goutham2018/Illizarov-Distraction-Osteogenesis/pcb_2.jpg

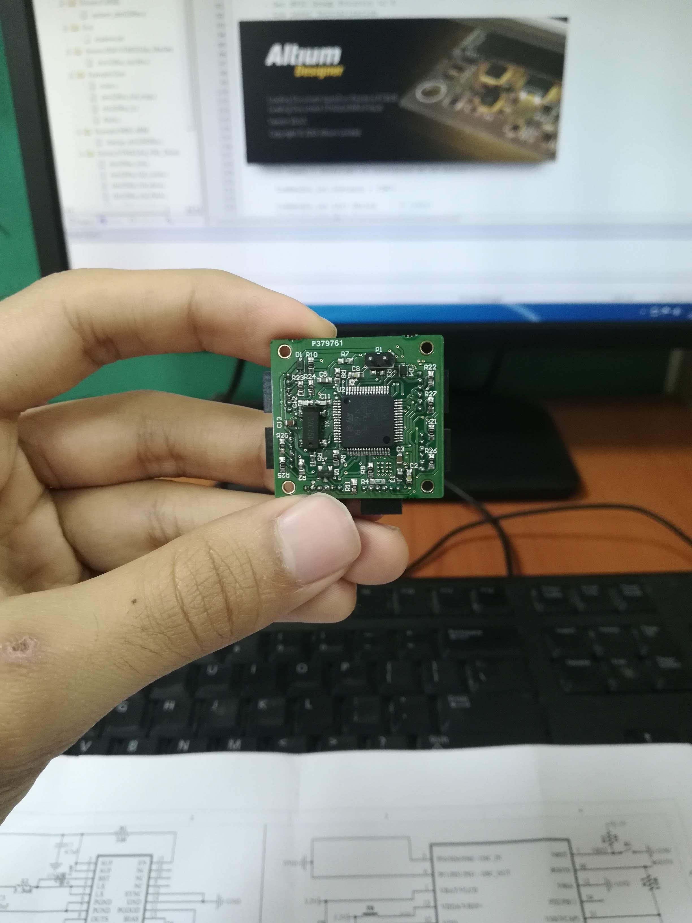
pcb_2.jpg
