goutham2018/Illizarov-Distraction-Osteogenesis/pcb_1.jpg

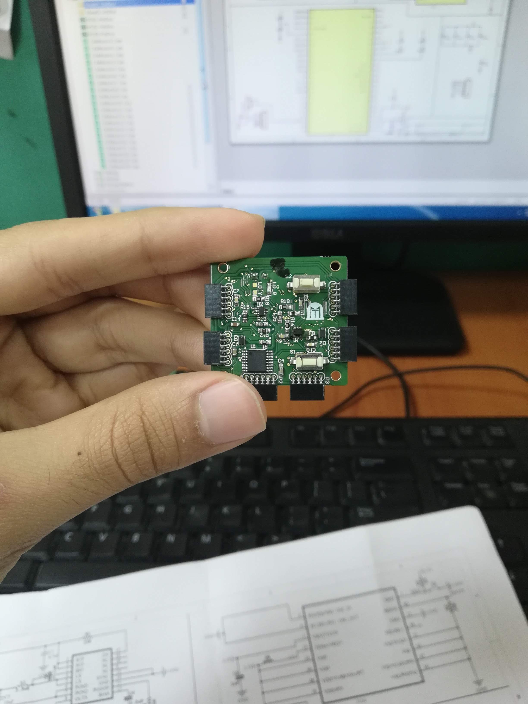
pcb_1.jpg
