goutham2018/Illizarov-Distraction-Osteogenesis/schematic/Illizarov.pdf

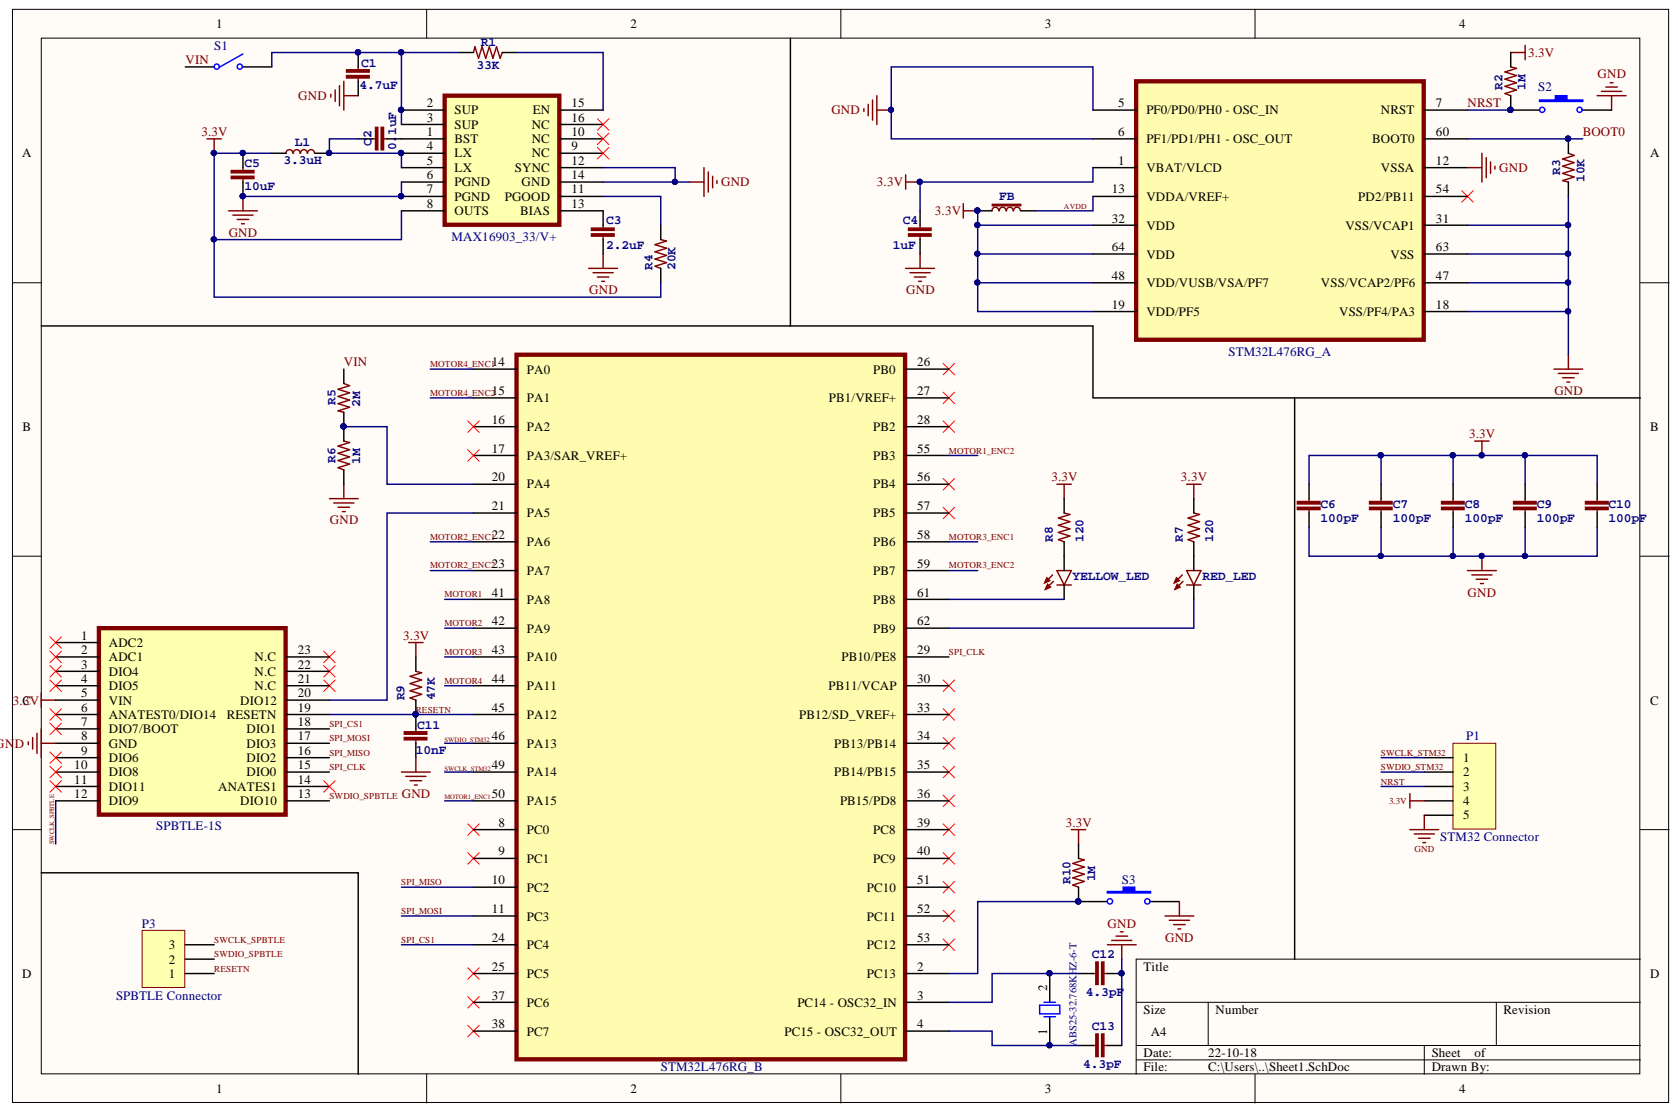
[picture p11: page 1]

SUP 2

VIN 5 | PA12 45
ANATEST0/DIO14 6 | | RESETN

DIO7/BOOT 7 | | C11 SWDIO_STM32 | PA13 46

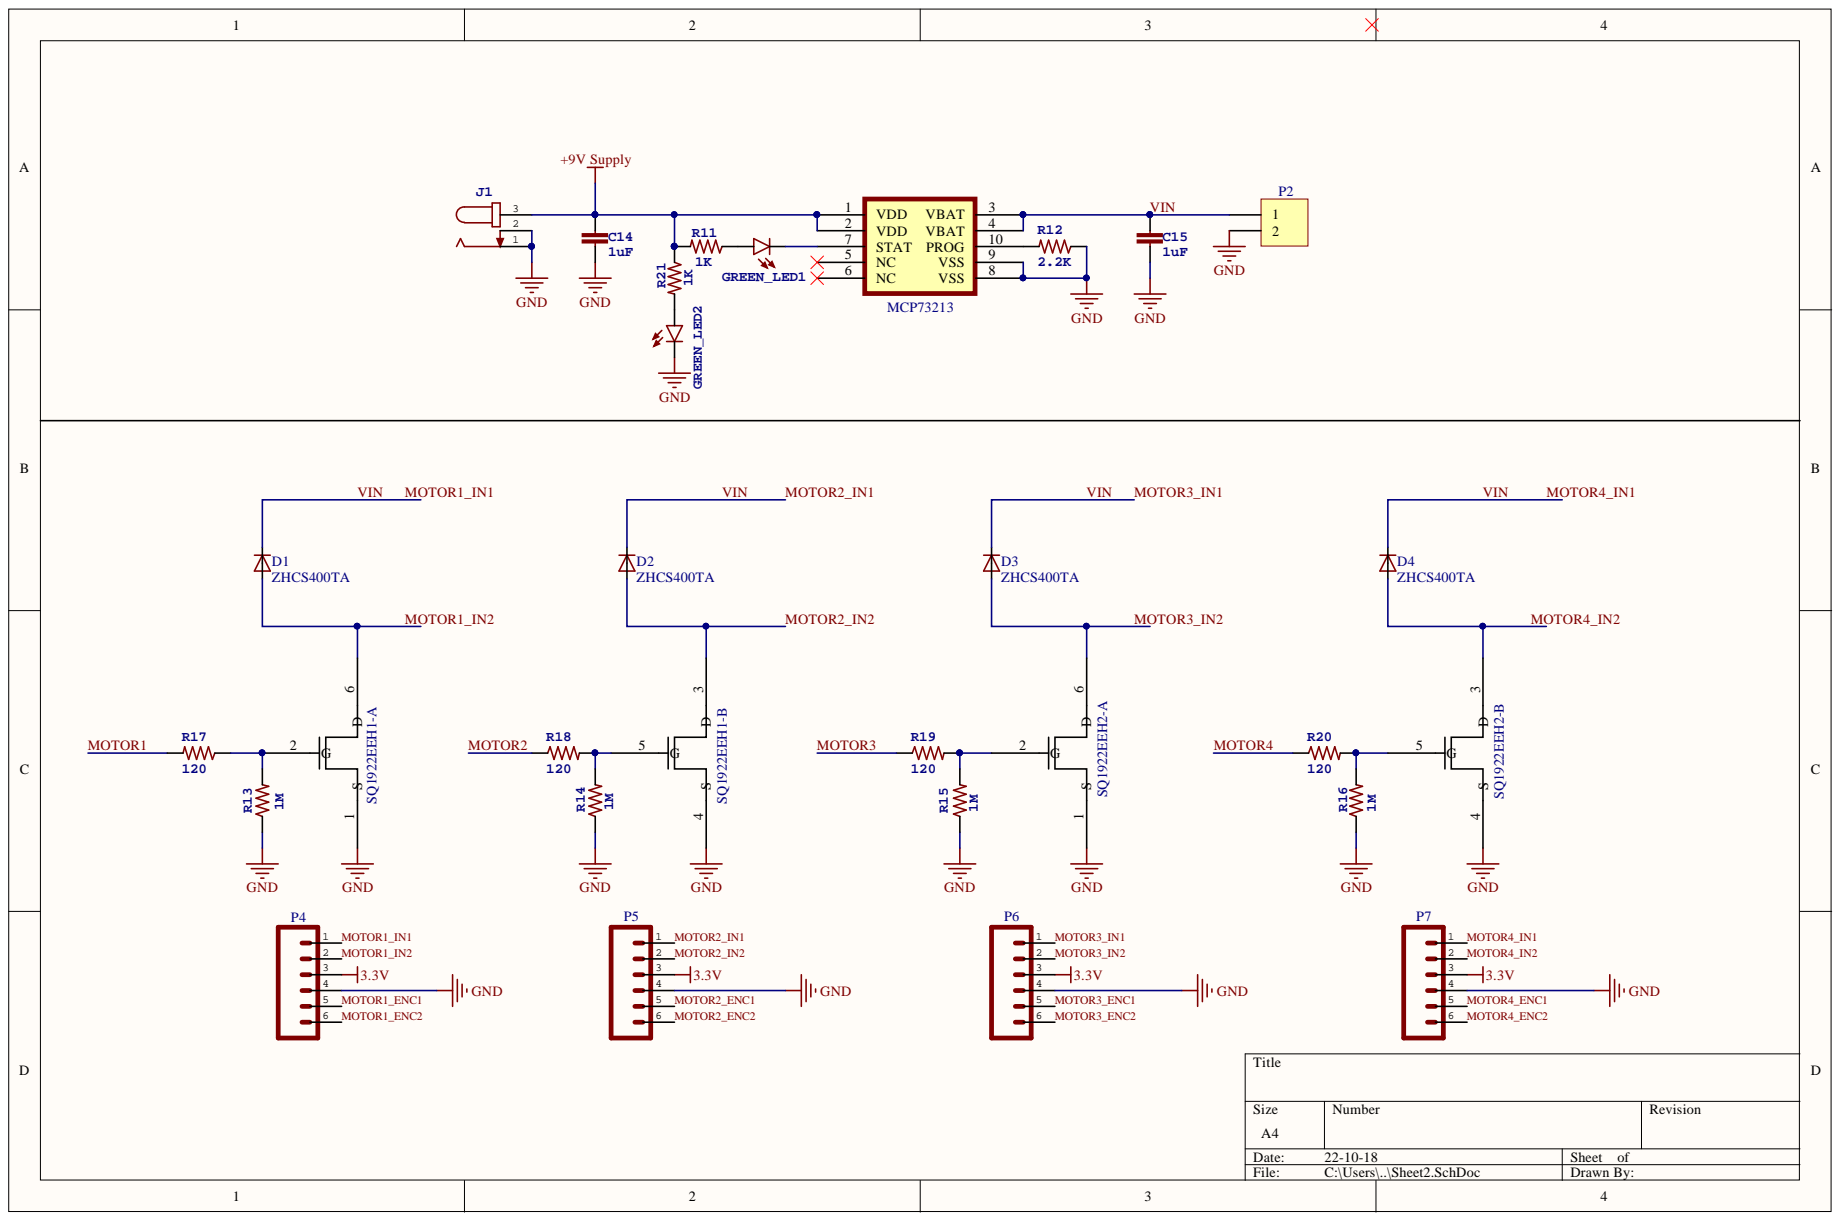
[picture p12: page 2]

2 | VDD 2
1 | STAT 7 NC 5
