goutham2018/Illizarov-Distraction-Osteogenesis/Inc/pin_config.h

#ifndef __PIN_CONFIG__
#define __PIN_CONFIG__

#define MOTOR_1_PORT_1 GPIOC
#define MOTOR_1_PORT_2 GPIOC

#define MOTOR_1_PIN_A GPIO_PIN_7
#define MOTOR_1_PIN_B GPIO_PIN_6

#define MOTOR_2_PORT_1 GPIOC
#define MOTOR_2_PORT_2 GPIOC

#define MOTOR_2_PIN_A GPIO_PIN_9
#define MOTOR_2_PIN_B GPIO_PIN_8

#define MOTOR_3_PORT_1 GPIOA
#define MOTOR_3_PORT_2 GPIOA

#define MOTOR_3_PIN_A GPIO_PIN_9
#define MOTOR_3_PIN_B GPIO_PIN_8

#define MOTOR_4_PORT_1 GPIOA
#define MOTOR_4_PORT_2 GPIOA

#define MOTOR_4_PIN_A GPIO_PIN_11
#define MOTOR_4_PIN_B GPIO_PIN_10

#define ENCODER_1_PIN_A_PORT GPIOA
#define ENCODER_1_PIN_A GPIO_PIN_15
#define ENCODER_1_PIN_B_PORT GPIOB
#define ENCODER_1_PIN_B GPIO_PIN_3

#define ENCODER_2_PIN_A_PORT GPIOA
#define ENCODER_2_PIN_B_PORT GPIOA
#define ENCODER_2_PIN_A GPIO_PIN_6
#define ENCODER_2_PIN_B GPIO_PIN_7

#define ENCODER_3_PIN_A_PORT GPIOB
#define ENCODER_3_PIN_B_PORT GPIOB
#define ENCODER_3_PIN_A GPIO_PIN_6
#define ENCODER_3_PIN_B GPIO_PIN_7

#define ENCODER_4_PIN_A_PORT GPIOA
#define ENCODER_4_PIN_B_PORT GPIOA
#define ENCODER_4_PIN_A GPIO_PIN_0
#define ENCODER_4_PIN_B GPIO_PIN_1


#endif
