goutham2018/Illizarov-Distraction-Osteogenesis/Inc/flash.h

/* Define to prevent recursive inclusion -------------------------------------*/
#ifndef __FLASH_H
#define __FLASH_H

/* Includes ------------------------------------------------------------------*/
#include "stm32l4xx_hal.h"
#include "stm32l4xx_nucleo.h"


/* Exported types ------------------------------------------------------------*/
/* Exported constants --------------------------------------------------------*/

#define DATA_BASE_START_ADDR   				ADDR_FLASH_PAGE_256   /* Start @ of data base area */
#define DATA_BASE_START_PAGE_NO				256

#define PATIENT_DETAILS_ADDR   				ADDR_FLASH_PAGE_261
#define PATIENT_DETAILS_PAGE_NO				261

#define DEVICE_CONFIG_ADDR     				ADDR_FLASH_PAGE_266
#define DEVICE_CONFIG_PAGE_NO					266

#define DEVICE_DATA_BACKUP_ADDR 			ADDR_FLASH_PAGE_271
#define DEVICE_DATA_BACKUP_PAGE_NO		271

#define MOTOR_1_DATA_BACKUP_ADDR 			ADDR_FLASH_PAGE_272
#define MOTOR_1_DATA_BACKUP_PAGE_NO		272

#define MOTOR_2_DATA_BACKUP_ADDR 			ADDR_FLASH_PAGE_273
#define MOTOR_2_DATA_BACKUP_PAGE_NO		273

#define MOTOR_3_DATA_BACKUP_ADDR 			ADDR_FLASH_PAGE_274
#define MOTOR_3_DATA_BACKUP_PAGE_NO 	274

#define MOTOR_4_DATA_BACKUP_ADDR 			ADDR_FLASH_PAGE_275
#define MOTOR_4_DATA_BACKUP_PAGE_NO		275

#define PATIENT_LOG_ADDR							ADDR_FLASH_PAGE_300
#define PATIENT_LOG_PAGE_NO						300
#define PATIENT_LOG_PAGES					200

#define flash_read_ok 0
/* Exported macro ------------------------------------------------------------*/
/* Base address of the Flash sectors */

#define ADDR_FLASH_PAGE_0     ((uint32_t)0x08000000) /* Base @ of Page 0, 2 Kbytes */
#define ADDR_FLASH_PAGE_1     ((uint32_t)0x08000800) /* Base @ of Page 1, 2 Kbytes */
#define ADDR_FLASH_PAGE_2     ((uint32_t)0x08001000) /* Base @ of Page 2, 2 Kbytes */
#define ADDR_FLASH_PAGE_3     ((uint32_t)0x08001800) /* Base @ of Page 3, 2 Kbytes */
#define ADDR_FLASH_PAGE_4     ((uint32_t)0x08002000) /* Base @ of Page 4, 2 Kbytes */
#define ADDR_FLASH_PAGE_5     ((uint32_t)0x08002800) /* Base @ of Page 5, 2 Kbytes */
#define ADDR_FLASH_PAGE_6     ((uint32_t)0x08003000) /* Base @ of Page 6, 2 Kbytes */
#define ADDR_FLASH_PAGE_7     ((uint32_t)0x08003800) /* Base @ of Page 7, 2 Kbytes */
#define ADDR_FLASH_PAGE_8     ((uint32_t)0x08004000) /* Base @ of Page 8, 2 Kbytes */
#define ADDR_FLASH_PAGE_9     ((uint32_t)0x08004800) /* Base @ of Page 9, 2 Kbytes */
#define ADDR_FLASH_PAGE_10    ((uint32_t)0x08005000) /* Base @ of Page 10, 2 Kbytes */
#define ADDR_FLASH_PAGE_11    ((uint32_t)0x08005800) /* Base @ of Page 11, 2 Kbytes */
#define ADDR_FLASH_PAGE_12    ((uint32_t)0x08006000) /* Base @ of Page 12, 2 Kbytes */
#define ADDR_FLASH_PAGE_13    ((uint32_t)0x08006800) /* Base @ of Page 13, 2 Kbytes */
#define ADDR_FLASH_PAGE_14    ((uint32_t)0x08007000) /* Base @ of Page 14, 2 Kbytes */
#define ADDR_FLASH_PAGE_15    ((uint32_t)0x08007800) /* Base @ of Page 15, 2 Kbytes */
#define ADDR_FLASH_PAGE_16    ((uint32_t)0x08008000) /* Base @ of Page 16, 2 Kbytes */
#define ADDR_FLASH_PAGE_17    ((uint32_t)0x08008800) /* Base @ of Page 17, 2 Kbytes */
#define ADDR_FLASH_PAGE_18    ((uint32_t)0x08009000) /* Base @ of Page 18, 2 Kbytes */
#define ADDR_FLASH_PAGE_19    ((uint32_t)0x08009800) /* Base @ of Page 19, 2 Kbytes */
#define ADDR_FLASH_PAGE_20    ((uint32_t)0x0800A000) /* Base @ of Page 20, 2 Kbytes */
#define ADDR_FLASH_PAGE_21    ((uint32_t)0x0800A800) /* Base @ of Page 21, 2 Kbytes */
#define ADDR_FLASH_PAGE_22    ((uint32_t)0x0800B000) /* Base @ of Page 22, 2 Kbytes */
#define ADDR_FLASH_PAGE_23    ((uint32_t)0x0800B800) /* Base @ of Page 23, 2 Kbytes */
#define ADDR_FLASH_PAGE_24    ((uint32_t)0x0800C000) /* Base @ of Page 24, 2 Kbytes */
#define ADDR_FLASH_PAGE_25    ((uint32_t)0x0800C800) /* Base @ of Page 25, 2 Kbytes */
#define ADDR_FLASH_PAGE_26    ((uint32_t)0x0800D000) /* Base @ of Page 26, 2 Kbytes */
#define ADDR_FLASH_PAGE_27    ((uint32_t)0x0800D800) /* Base @ of Page 27, 2 Kbytes */
#define ADDR_FLASH_PAGE_28    ((uint32_t)0x0800E000) /* Base @ of Page 28, 2 Kbytes */
#define ADDR_FLASH_PAGE_29    ((uint32_t)0x0800E800) /* Base @ of Page 29, 2 Kbytes */
#define ADDR_FLASH_PAGE_30    ((uint32_t)0x0800F000) /* Base @ of Page 30, 2 Kbytes */
#define ADDR_FLASH_PAGE_31    ((uint32_t)0x0800F800) /* Base @ of Page 31, 2 Kbytes */
#define ADDR_FLASH_PAGE_32    ((uint32_t)0x08010000) /* Base @ of Page 32, 2 Kbytes */
#define ADDR_FLASH_PAGE_33    ((uint32_t)0x08010800) /* Base @ of Page 33, 2 Kbytes */
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
#define ADDR_FLASH_PAGE_490   ((uint32_t)0x080f5000) /* Base @ of Page 490, 2 Kbytes */
#define ADDR_FLASH_PAGE_491   ((uint32_t)0x080f5800) /* Base @ of Page 491, 2 Kbytes */
#define ADDR_FLASH_PAGE_492   ((uint32_t)0x080f6000) /* Base @ of Page 492, 2 Kbytes */
#define ADDR_FLASH_PAGE_493   ((uint32_t)0x080f6800) /* Base @ of Page 493, 2 Kbytes */
#define ADDR_FLASH_PAGE_494   ((uint32_t)0x080f7000) /* Base @ of Page 494, 2 Kbytes */
#define ADDR_FLASH_PAGE_495   ((uint32_t)0x080f7800) /* Base @ of Page 495, 2 Kbytes */
#define ADDR_FLASH_PAGE_496   ((uint32_t)0x080f8000) /* Base @ of Page 496, 2 Kbytes */
#define ADDR_FLASH_PAGE_497   ((uint32_t)0x080f8800) /* Base @ of Page 497, 2 Kbytes */
#define ADDR_FLASH_PAGE_498   ((uint32_t)0x080f9000) /* Base @ of Page 498, 2 Kbytes */
#define ADDR_FLASH_PAGE_499   ((uint32_t)0x080f9800) /* Base @ of Page 499, 2 Kbytes */
#define ADDR_FLASH_PAGE_500   ((uint32_t)0x080fa000) /* Base @ of Page 500, 2 Kbytes */
#define ADDR_FLASH_PAGE_501   ((uint32_t)0x080fa800) /* Base @ of Page 501, 2 Kbytes */
#define ADDR_FLASH_PAGE_502   ((uint32_t)0x080fb000) /* Base @ of Page 502, 2 Kbytes */
#define ADDR_FLASH_PAGE_503   ((uint32_t)0x080fb800) /* Base @ of Page 503, 2 Kbytes */
#define ADDR_FLASH_PAGE_504   ((uint32_t)0x080fc000) /* Base @ of Page 504, 2 Kbytes */
#define ADDR_FLASH_PAGE_505   ((uint32_t)0x080fc800) /* Base @ of Page 505, 2 Kbytes */
#define ADDR_FLASH_PAGE_506   ((uint32_t)0x080fd000) /* Base @ of Page 506, 2 Kbytes */
#define ADDR_FLASH_PAGE_507   ((uint32_t)0x080fd800) /* Base @ of Page 507, 2 Kbytes */
#define ADDR_FLASH_PAGE_508   ((uint32_t)0x080fe000) /* Base @ of Page 508, 2 Kbytes */
#define ADDR_FLASH_PAGE_509   ((uint32_t)0x080fe800) /* Base @ of Page 509, 2 Kbytes */
#define ADDR_FLASH_PAGE_510   ((uint32_t)0x080ff000) /* Base @ of Page 510, 2 Kbytes */
#define ADDR_FLASH_PAGE_511   ((uint32_t)0x080ff800) /* Base @ of Page 511, 2 Kbytes */


/* Exported functions ------------------------------------------------------- */
int	flash_write(uint64_t Address, int length, uint64_t *data, uint32_t OFFSET);
int flash_erase( uint32_t Address , uint32_t NoOfPages);
int flash_read( uint32_t Address, int length ,uint64_t *data);

#endif /* __FLASH_H */
