goutham2018/Illizarov-Distraction-Osteogenesis/Inc/uart.h

#ifndef __UART__
#define __UART__

#include "main.h"


//#define __cplusplus
//#undef __STDIO_NO_EXPORTS

//#define PUTCHAR_PROTOTYPE 
//int fputc(int , FILE *);


/* Definition for USARTx clock resources */
#define USARTx                           USART2
#define USARTx_CLK_ENABLE()              __HAL_RCC_USART2_CLK_ENABLE()
#define USARTx_RX_GPIO_CLK_ENABLE()      __HAL_RCC_GPIOA_CLK_ENABLE()
#define USARTx_TX_GPIO_CLK_ENABLE()      __HAL_RCC_GPIOA_CLK_ENABLE()

#define USARTx_FORCE_RESET()             __HAL_RCC_USART2_FORCE_RESET()
#define USARTx_RELEASE_RESET()           __HAL_RCC_USART2_RELEASE_RESET()

/* Definition for USARTx Pins */
#define USARTx_TX_PIN                    GPIO_PIN_2
#define USARTx_TX_GPIO_PORT              GPIOA
#define USARTx_TX_AF                     GPIO_AF7_USART2
#define USARTx_RX_PIN                    GPIO_PIN_3
#define USARTx_RX_GPIO_PORT              GPIOA
#define USARTx_RX_AF                     GPIO_AF7_USART2

/* Definition for USARTx's NVIC */
#define USARTx_IRQn                      USART2_IRQn
#define USARTx_IRQHandler                USART2_IRQHandler

/* Size of Trasmission buffer */
#define TXBUFFERSIZE                      (COUNTOF(aTxBuffer) - 1)
/* Size of Reception buffer */
#define RXBUFFERSIZE                      (COUNTOF(aRxBuffer) - 1)

/* Exported macro ------------------------------------------------------------*/
#define COUNTOF(__BUFFER__)   (sizeof(__BUFFER__) / sizeof(*(__BUFFER__)))
/* Exported functions ------------------------------------------------------- */
void uart_config(void);
void HAL_UART_TxCpltCallback(UART_HandleTypeDef *UartHandle);
void HAL_UART_RxCpltCallback(UART_HandleTypeDef *UartHandle);
void uart_transmit(char aTxBuffer[35], uint32_t BuffSize);
int string_length(char s[]);
void serial_receive(void);
void ResetRxIT(UART_HandleTypeDef *UartHandle);
extern char dispvar[150];
extern char errvar[150];
void serial_printf(void);

#endif 
